pauldueck208-blip/22re-Tachometer-Driver-board/Board type A V1 Schematic.png

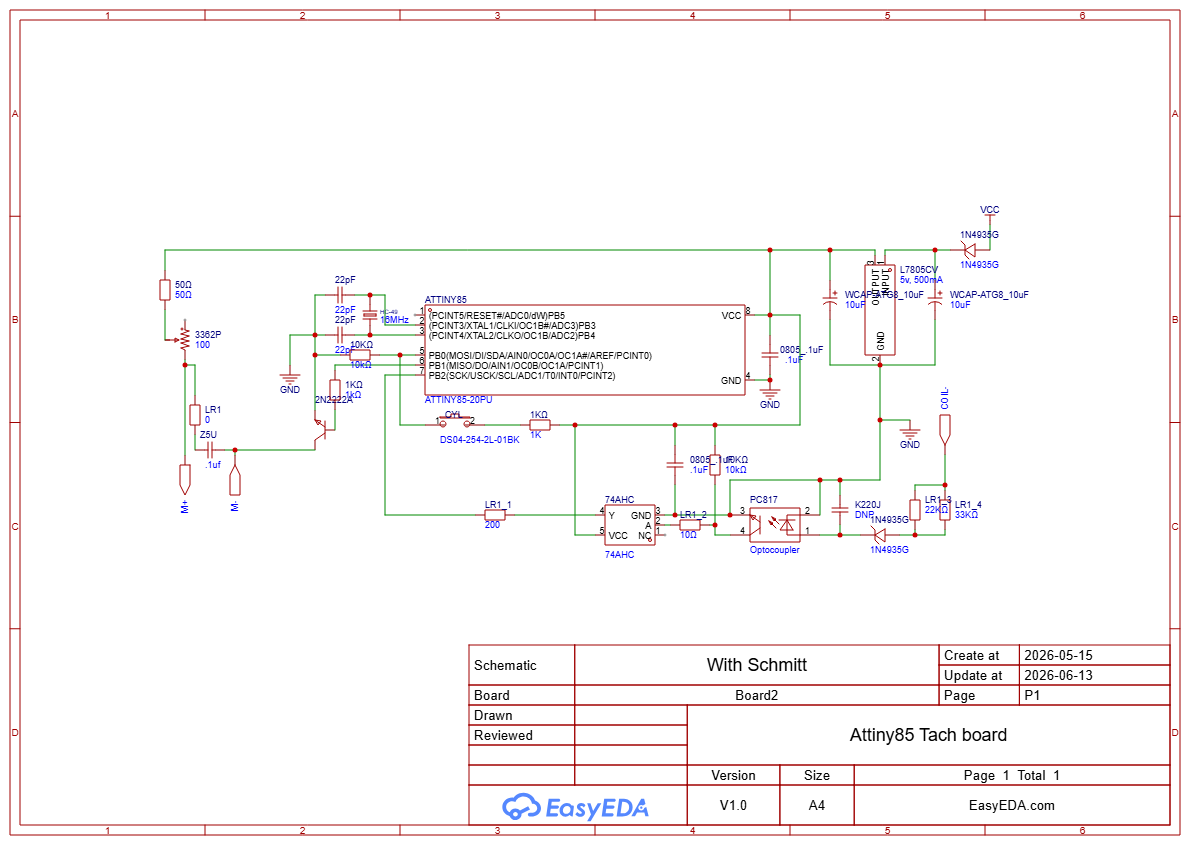
Board type A V1 Schematic.png
