pauldueck208-blip/22re-Tachometer-Driver-board/Images/20260428_142108.jpg

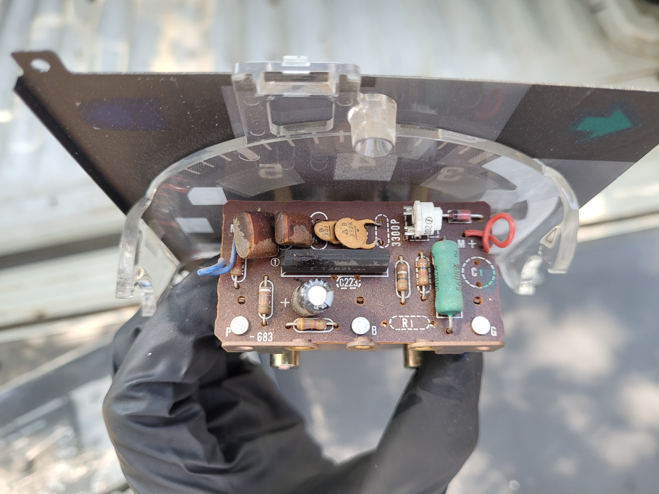
Images/20260428_142108.jpg
