pauldueck208-blip/22re-Tachometer-Driver-board/Images/20260625_104025.jpg

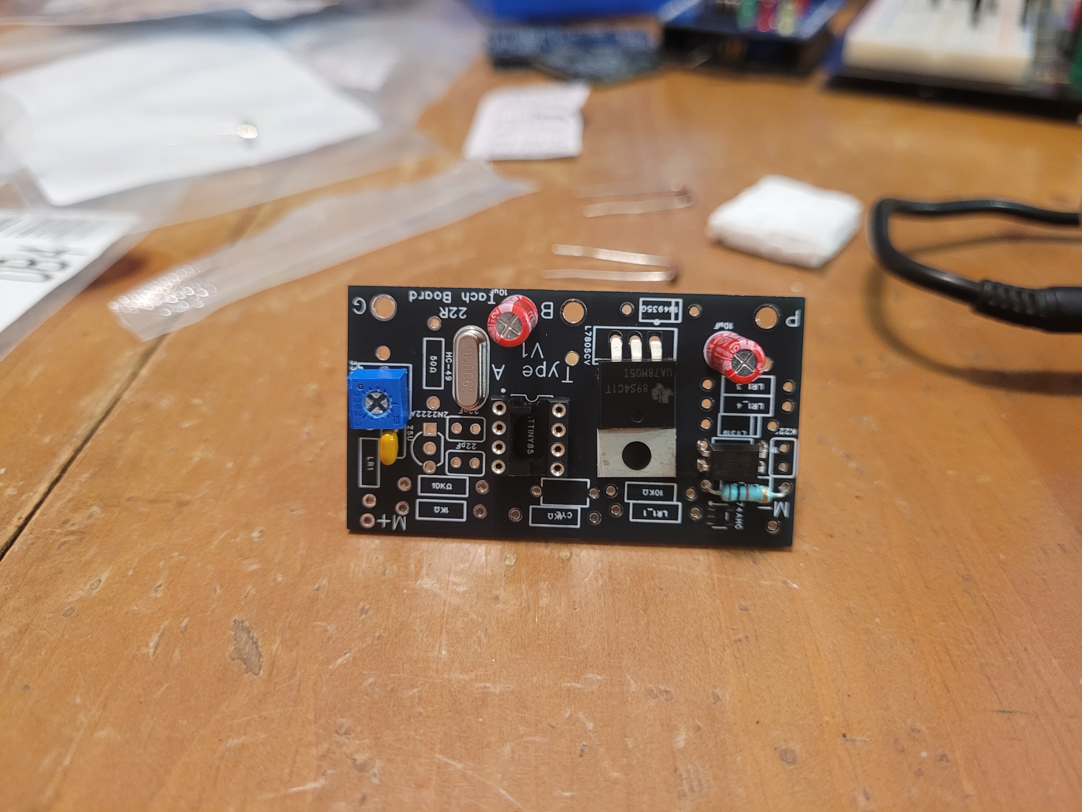
Images/20260625_104025.jpg
