pauldueck208-blip/22re-Tachometer-Driver-board/Images/Screenshot 2026-07-05 162918.png

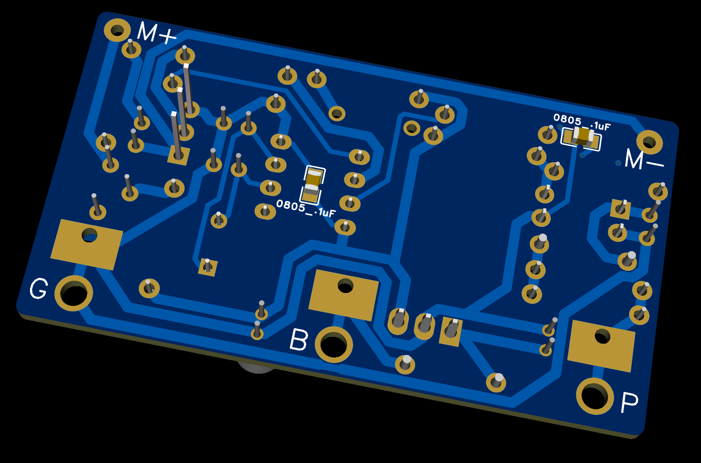
Images/Screenshot 2026-07-05 162918.png
