pauldueck208-blip/22re-Tachometer-Driver-board/(list of files, drawings)

Other design files:
Attiny85 Tach board.eprj
