pauldueck208-blip/22re-Tachometer-Driver-board/(commit log)

2026-06-27 First versions of the board and code.
    [Attiny85 Tach board.eprj]
2026-06-28 Added Tachometer boards V1
    [4runner tachometer board.eprj]
2026-06-28 Added wrong file
    [4runner tachometer board.eprj]
2026-06-28 Added the correct tach boards
    [Attiny85 Tach board.eprj]
2026-07-06 Updated code and instructions, added pictures and Gerbers.
    Added more pictures of the board, updated code with newer filtering values, added instructions and better notes
    [Attiny85 Tach board.eprj]
